mordae/barbecue/hw/barbecue/components/PJ-102AH.step

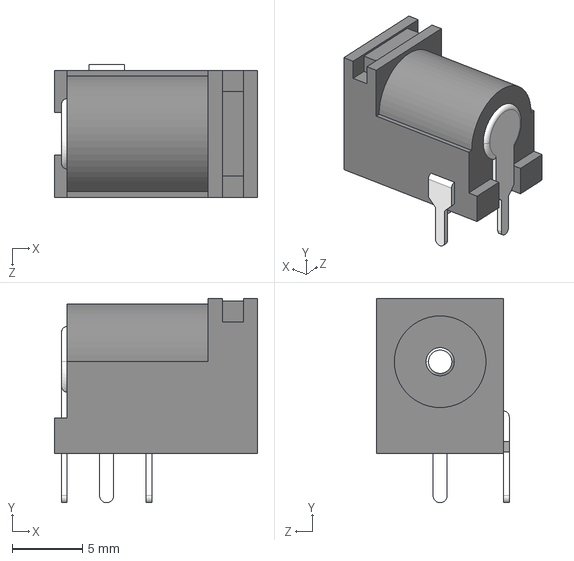
[picture p1: CAD file, 2022-12-15]
hw/barbecue/components/PJ-102AH.step
14.4 x 14.5 x 9.40 mm
