mordae/barbecue/hw/barbecue/components/EN11-HSM1AF15.step

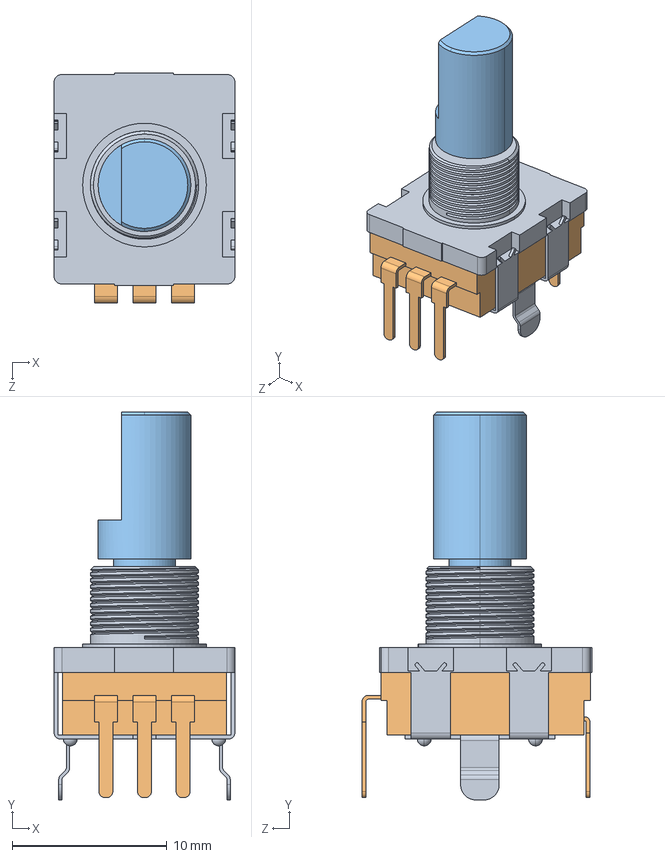
[picture p2: CAD file, 2022-12-15]
hw/barbecue/components/EN11-HSM1AF15.step
11.7 x 25.1 x 14.9 mm
