mordae/barbecue/hw/barbecue/components/D0008A.stp

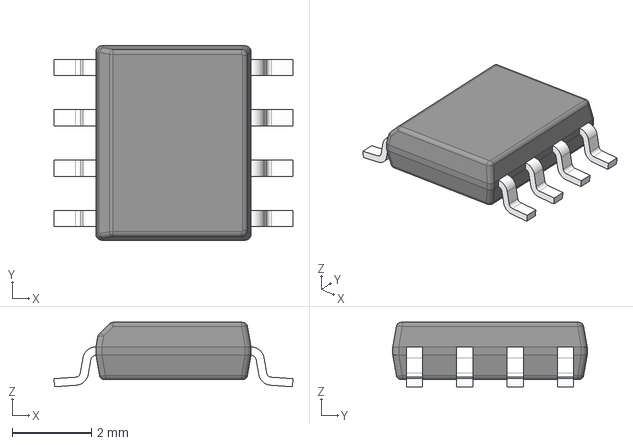
[picture p3: CAD file, 2022-12-15]
hw/barbecue/components/D0008A.stp
6.02 x 4.90 x 1.63 mm
BODY-SO
LEAD-D0008A x 8
