mordae/barbecue/hw/barbecue/components/W25Q128JVSIQ.step

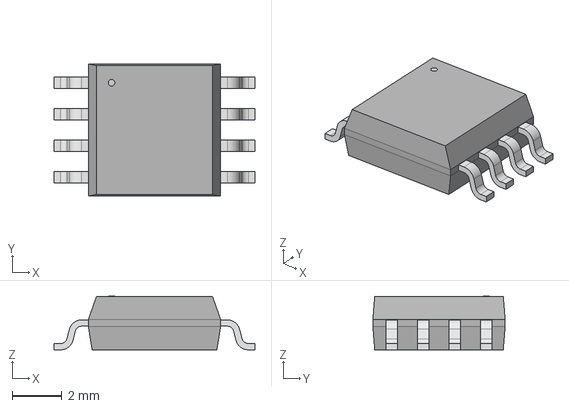
[picture p4: CAD file, 2022-12-15]
hw/barbecue/components/W25Q128JVSIQ.step
8.10 x 5.33 x 2.16 mm
