mordae/barbecue/hw/barbecue/components/47590-0001.stp

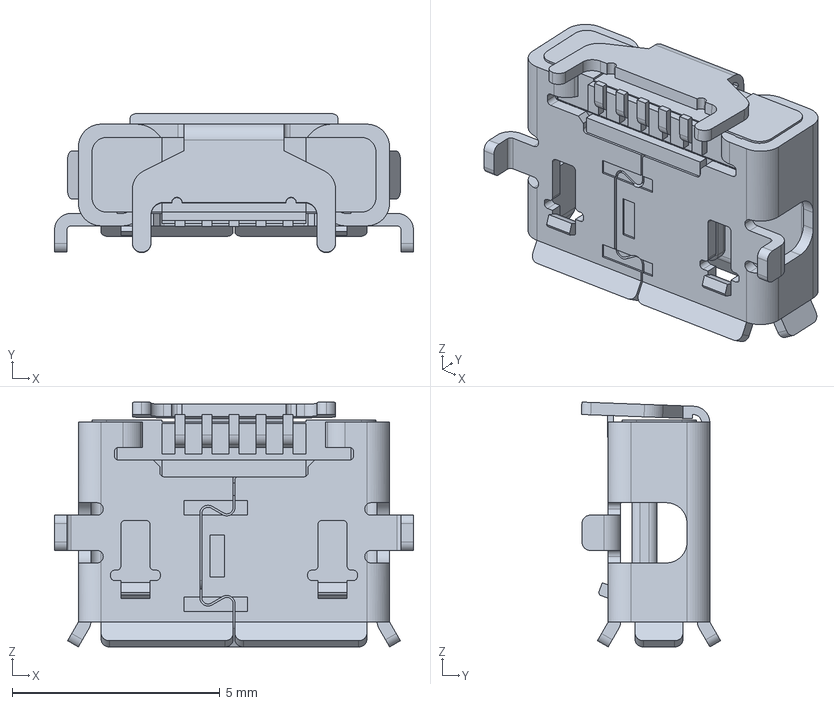
[picture p5: CAD file, 2022-12-15]
hw/barbecue/components/47590-0001.stp
8.65 x 3.36 x 5.90 mm
