mordae/barbecue/hw/barbecue/barbecue.kicad_pcb

## KiCad design hw/barbecue/barbecue.kicad_pcb (2023-01-16)

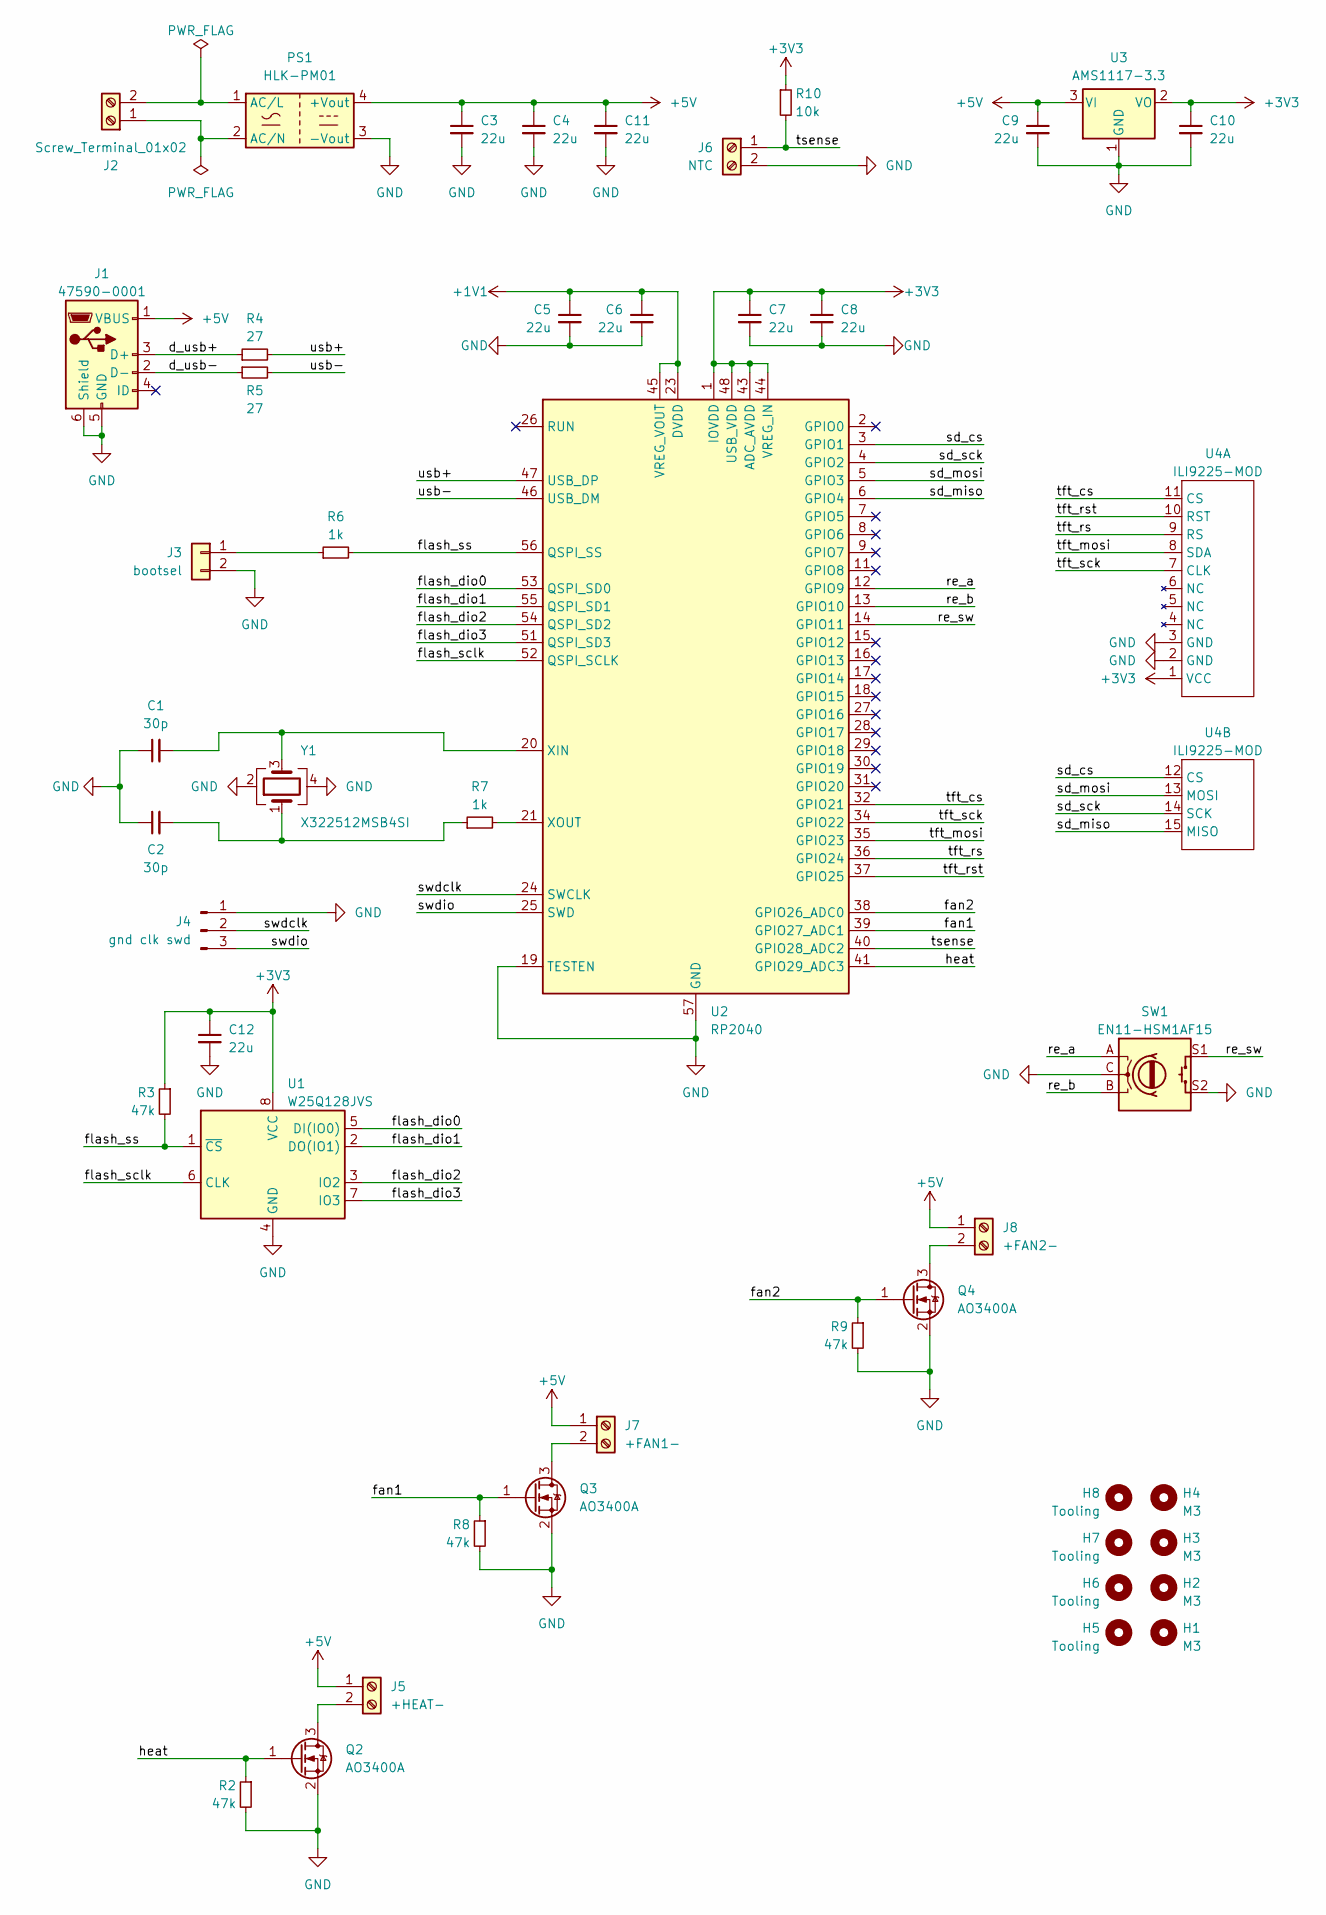
[picture p6: schematic barbecue.kicad_sch]

Parts:
C1, C2: 30p; C_0402_1005Metric
C3, C4, C5, C6, C7, C8, C9, C10, C11, C12: 22u; C_0603_1608Metric
H1, H2, H3, H4: M3; MountingHole_3.2mm_M3
H5, H6, H7, H8: Tooling; ToolingHole
J1: 47590-0001; USB_Micro-AB_Molex_47590-0001
J2: Screw_Terminal_01x02; TerminalBlock_Altech_AK300-2_P5.00mm
J3: bootsel; PinHeader_1x02_P2.54mm_Vertical
J4: gnd clk swd; PinHeader_1x03_P2.54mm_Vertical
J5: +HEAT-; TerminalBlock_TE_282834-2_1x02_P2.54mm_Horizontal
J6: NTC; TerminalBlock_TE_282834-2_1x02_P2.54mm_Horizontal
J7: +FAN1-; TerminalBlock_TE_282834-2_1x02_P2.54mm_Horizontal
J8: +FAN2-; TerminalBlock_TE_282834-2_1x02_P2.54mm_Horizontal
PS1: HLK-PM01; Converter_ACDC_HiLink_HLK-PMxx
Q2, Q3, Q4: AO3400A; SOT-23
R2, R3, R8, R9: 47k; R_0402_1005Metric
R4, R5: 27; R_0603_1608Metric
R6, R7: 1k; R_0402_1005Metric
R10: 10k; R_0603_1608Metric
SW1: EN11-HSM1AF15
U1: W25Q128JVS; SOIC-8_5.23x5.23mm_P1.27mm
U2: RP2040; QFN-56-1EP_7x7mm_P0.4mm_EP3.2x3.2mm
U3: AMS1117-3.3; SOT-223-3_TabPin2
U4: ILI9225-MOD
Y1: X322512MSB4SI; Crystal_SMD_3225-4Pin_3.2x2.5mm

Connections:
+1V1: C5.1, C6.1, U2.23 (DVDD), U2.45 (VREG_VOUT), U2.50 (DVDD)
+3V3: C7.1, C8.1, C10.1, C12.1, R3.1, R10.1, U1.8 (VCC), U2.1 (IOVDD), U2.10 (IOVDD), U2.22 (IOVDD), U2.33 (IOVDD), U2.42 (IOVDD), U2.43 (ADC_AVDD), U2.44 (VREG_IN), U2.48 (USB_VDD), U2.49 (IOVDD), U3.2 (VO), U4.1 (VCC)
+5V: C3.1, C4.1, C9.1, C11.1, J1.1 (VBUS), J5.1, J7.1, J8.1, PS1.4 (+Vout), U3.3 (VI)
/d_usb+: J1.3 (D+), R4.1
/d_usb-: J1.2 (D-), R5.1
/fan1: Q3.1 (G), R8.1, U2.39 (GPIO27_ADC1)
/fan2: Q4.1 (G), R9.1, U2.38 (GPIO26_ADC0)
/flash_dio0: U1.5 (DI(IO0)), U2.53 (QSPI_SD0)
/flash_dio1: U1.2 (DO(IO1)), U2.55 (QSPI_SD1)
/flash_dio2: U1.3 (IO2), U2.54 (QSPI_SD2)
/flash_dio3: U1.7 (IO3), U2.51 (QSPI_SD3)
/flash_sclk: U1.6 (CLK), U2.52 (QSPI_SCLK)
/flash_ss: R3.2, R6.2, U1.1 (~CS), U2.56 (QSPI_SS)
/heat: Q2.1 (G), R2.1, U2.41 (GPIO29_ADC3)
/re_a: SW1.A, U2.12 (GPIO9)
/re_b: SW1.B, U2.13 (GPIO10)
/re_sw: SW1.S1, U2.14 (GPIO11)
/sd_cs: U2.3 (GPIO1), U4.12 (CS)
/sd_miso: U2.6 (GPIO4), U4.15 (MISO)
/sd_mosi: U2.5 (GPIO3), U4.13 (MOSI)
/sd_sck: U2.4 (GPIO2), U4.14 (SCK)
/swdclk: J4.2, U2.24 (SWCLK)
/swdio: J4.3, U2.25 (SWD)
/tft_cs: U2.32 (GPIO21), U4.11 (CS)
/tft_mosi: U2.35 (GPIO23), U4.8 (SDA)
/tft_rs: U2.36 (GPIO24), U4.9 (RS)
/tft_rst: U2.37 (GPIO25), U4.10 (RST)
/tft_sck: U2.34 (GPIO22), U4.7 (CLK)
/tsense: J6.1, R10.2, U2.40 (GPIO28_ADC2)
/usb+: R4.2, U2.47 (USB_DP)
/usb-: R5.2, U2.46 (USB_DM)
GND: C1.1, C2.1, C3.2, C4.2, C5.2, C6.2, C7.2, C8.2, C9.2, C10.2, C11.2, C12.2, J1.5 (GND), J1.6 (Shield), J3.2, J4.1, J6.2, PS1.3 (-Vout), Q2.2 (S), Q3.2 (S), Q4.2 (S), R2.2, R8.2, R9.2, SW1.C, SW1.S2, U1.4 (GND), U2.19 (TESTEN), U2.57 (GND), U3.1 (GND), U4.2 (GND), U4.3 (GND), Y1.2, Y1.4
unnamed: C2.2, R7.1, Y1.1
unnamed: J2.1, PS1.2 (AC/N)
unnamed: J2.2, PS1.1 (AC/L)
unnamed: J3.1, R6.1
unnamed: J5.2, Q2.3 (D)
unnamed: J7.2, Q3.3 (D)
unnamed: J8.2, Q4.3 (D)
unnamed: C1.2, U2.20 (XIN), Y1.3
unnamed: R7.2, U2.21 (XOUT)

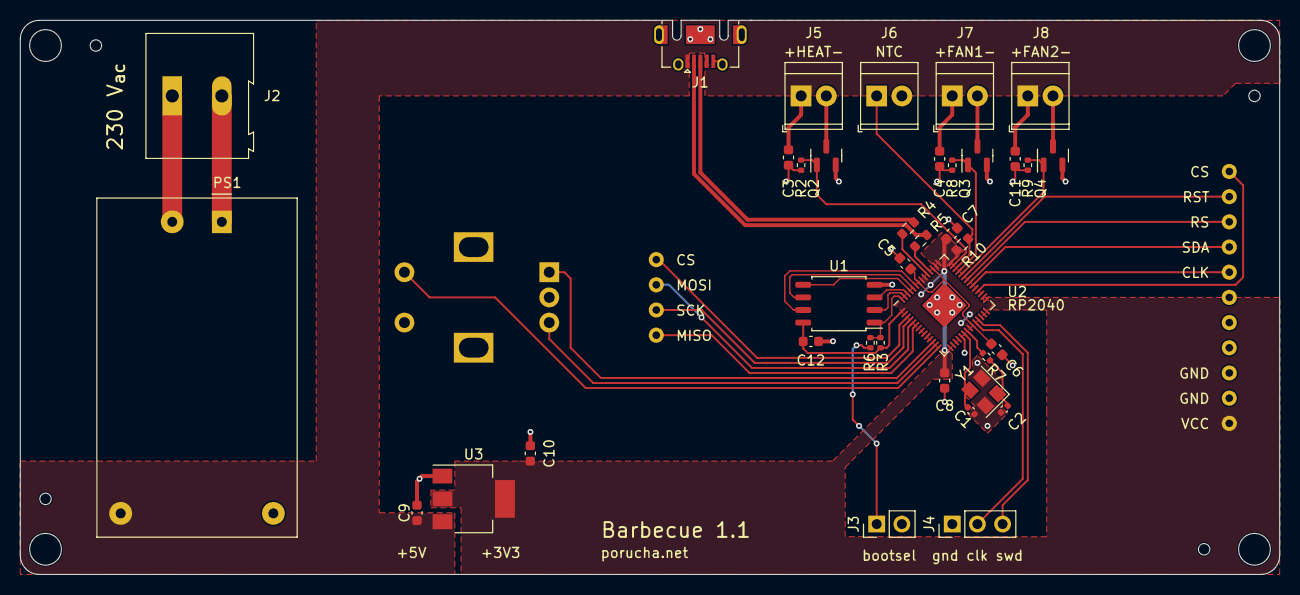
[picture p7: board barbecue.kicad_pcb from above]

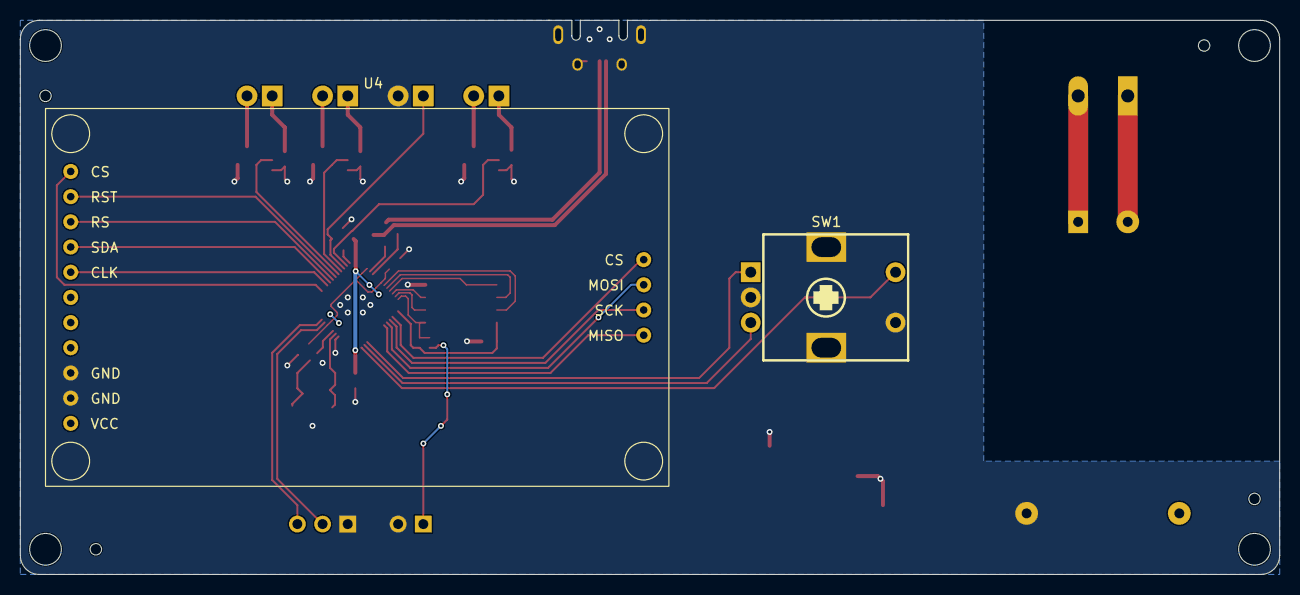
[picture p8: board barbecue.kicad_pcb from below]

Board: 2 copper layers, 127.0 x 55.9 mm, 47 parts (2 on the bottom side), 41 nets.
