mordae/barbecue/(commit log)

2022-12-15 Initial import
    [47590-0001.stp, D0008A.stp, EN11-HSM1AF15.step, PJ-102AH.step, W25Q128JVSIQ.step, barbecue.kicad_pcb, barbecue.kicad_sch]
2022-12-26 Small board fixes
    [barbecue.kicad_pcb]
2022-12-26 Save board-related options in the CMakeLists.txt
2022-12-27 Test temperature readout
2022-12-30 Fix board PWM outputs
    [barbecue.kicad_pcb, barbecue.kicad_sch]
2023-01-06 task: fix and introduce SDK compat layer
    [task.c, task.h]
2023-01-06 renc: interrupt-based rotary encoder input
2023-01-06 renc: remove leftover esp32 code
2023-01-07 renc: remove leftover commented-out printf
2023-01-07 Fix task stats header format
    [main.c]
2023-01-07 task: replace task_yield_to_any with task_yield_until_event
    [task.c, task.h]
2023-01-07 task: redesign blocking to avoid needless wakeups
    [main.c, task.c, task.h]
2023-01-08 task: redesign readiness and stack handling
    [main.c, task.c, task.h]
2023-01-08 Improve calibration
2023-01-09 Increase stats task priority
    This avoids starvation by more greedy tsense task.
    [main.c]
2023-01-09 ili9225: Parallelize transmission using DMA
2023-01-09 task: avoid deadlock with short alarm timeout
    [task.c]
2023-01-10 renc: redesign for improved reliability
    [barbecue10.h, main.c, renc.c]
2023-01-10 renc: handle maximum rotation speed correctly
    [renc.c]
2023-01-13 Calibrate higher temps against my multimeter
2023-01-16 Version 1.1 as sent to manufacturing
    [barbecue.kicad_pcb, barbecue.kicad_sch]
2023-02-06 Fixes and new board
    [barbecue11.h, main.c, renc.c, scene.c, scene.h, task.c, task.h]
2023-02-07 Generalize TFT drivers and use common <tft.h>
2023-02-07 Extract display driver
